matthieuvigne/eurobot_beacon/Documentation/Figures/IC_Documentation_Receiver.pdf

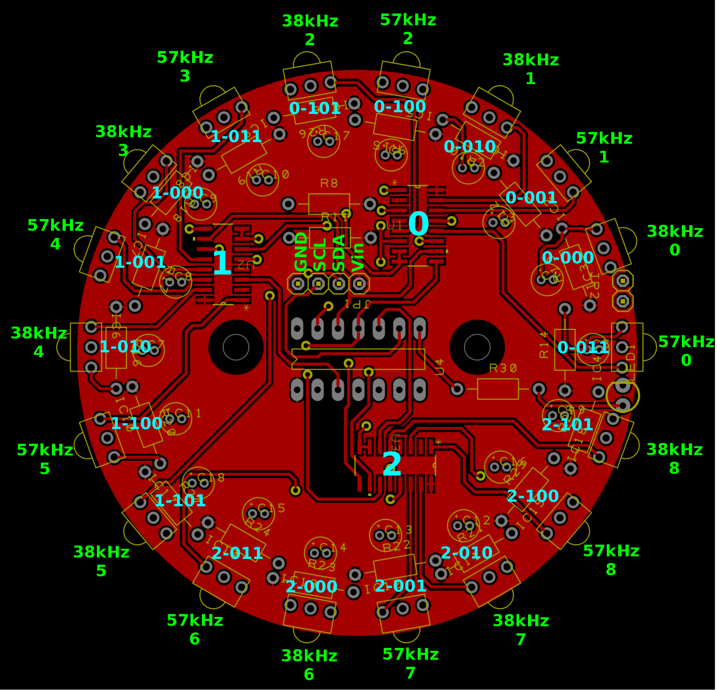
[picture p8: page 1]

0
1

2

0-011

1-011

2-011

0-000

0-001

0-010

0-101 0-100

2-101

1-101 | 2-100

1-100

2-010

1-010

2-001

1-001

1-000

2-000
