matthieuvigne/eurobot_beacon/PCBs/ATTinyProgrammerBoard-Schematic.pdf

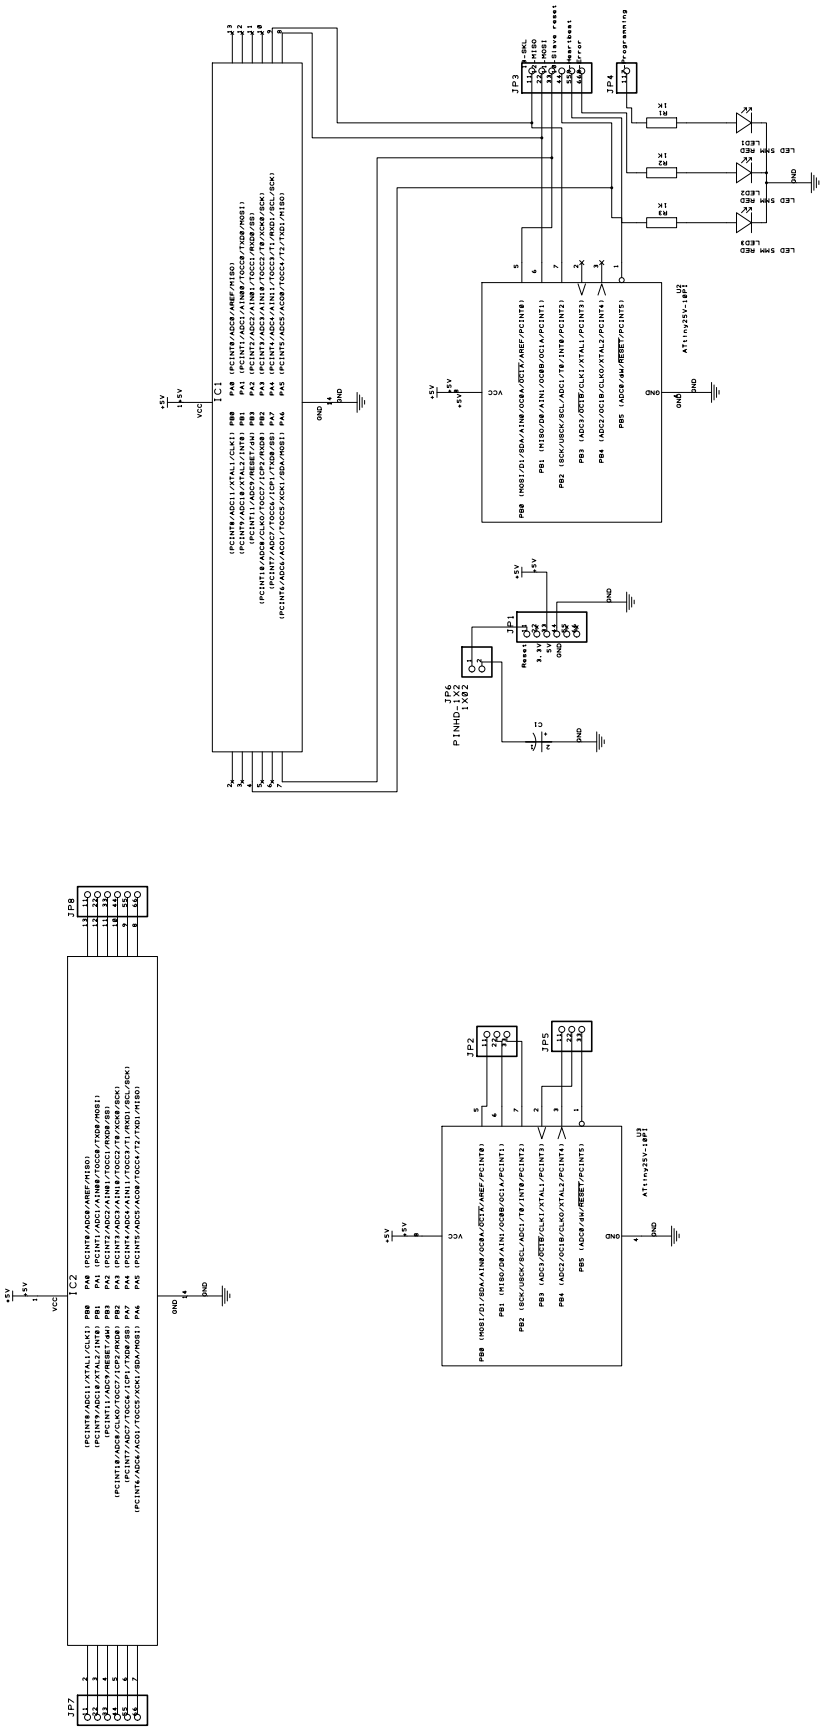
[picture p9: page 1]
