matthieuvigne/eurobot_beacon/PCBs/Emitter-Schematic.pdf

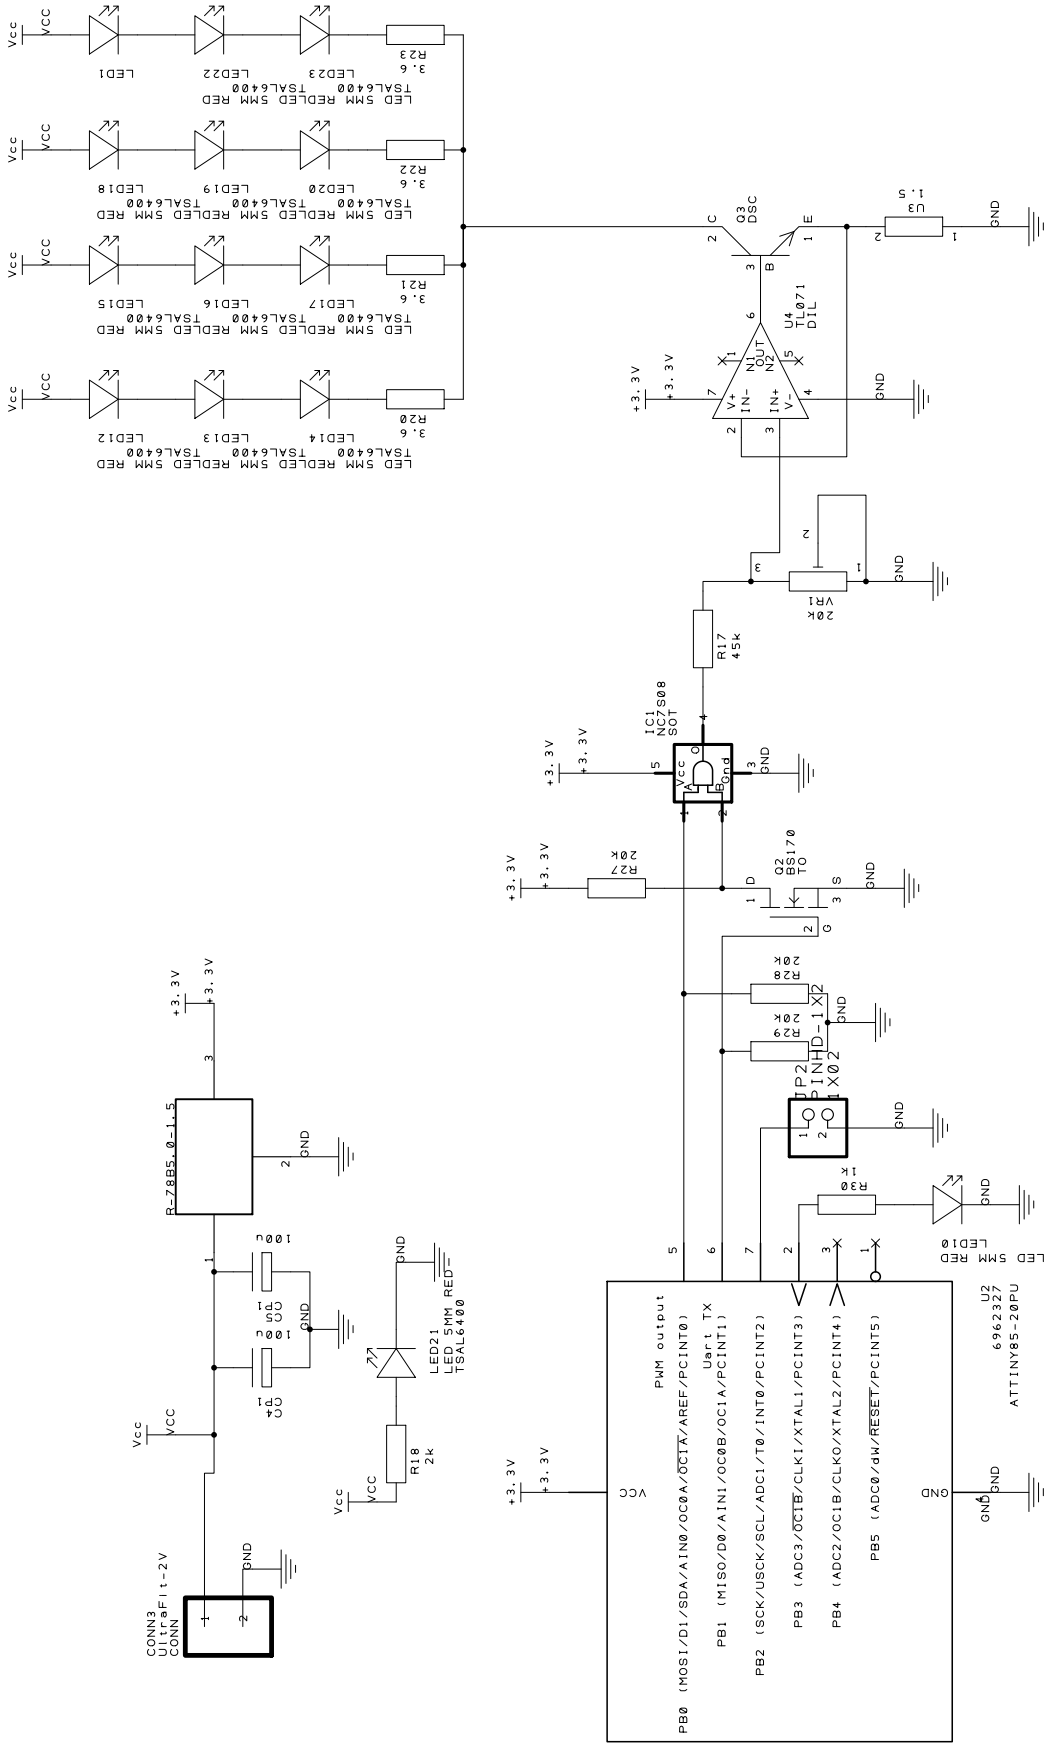
[picture p10: page 1]
