matthieuvigne/eurobot_beacon/PCBs/Reciever-Schematic.pdf

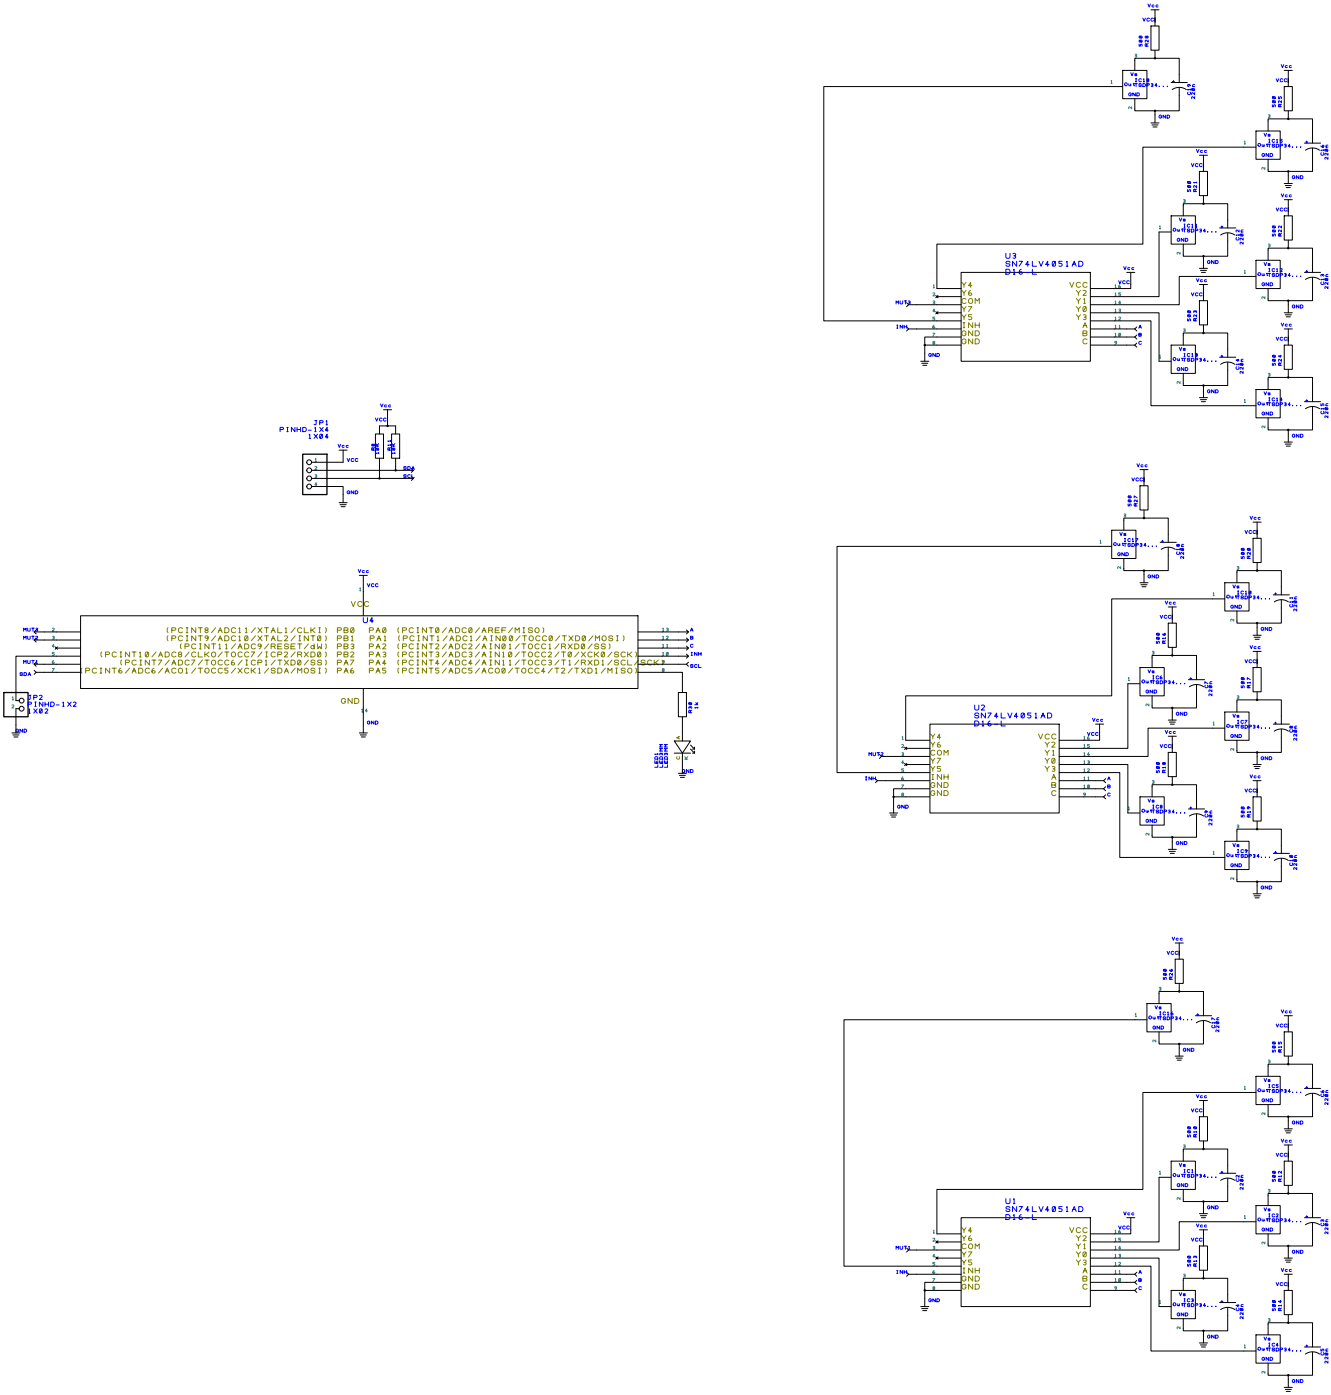
[picture p11: page 1]
