matthieuvigne/eurobot_beacon/PCBs/ATTinyProgrammerBoard-PCB.pdf

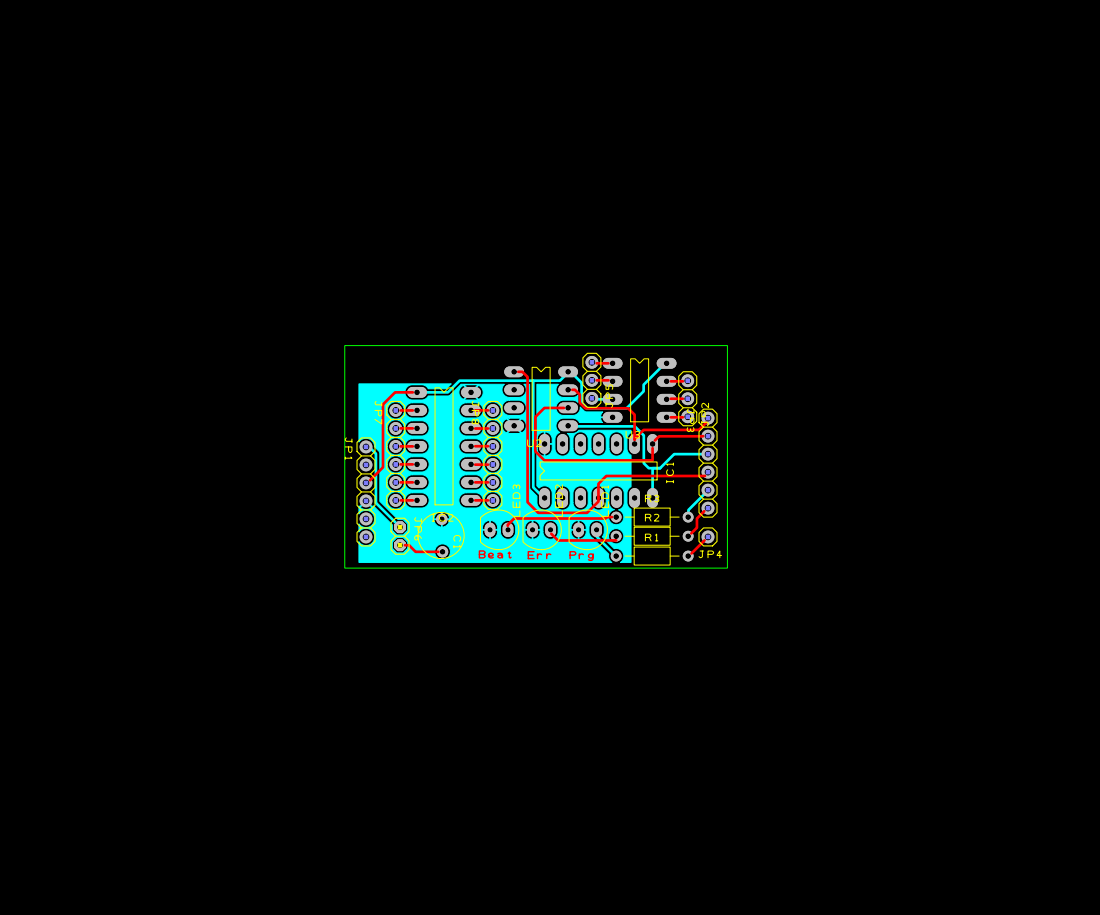
[picture p12: page 1]
