matthieuvigne/eurobot_beacon/PCBs/Emitter-PCB.pdf

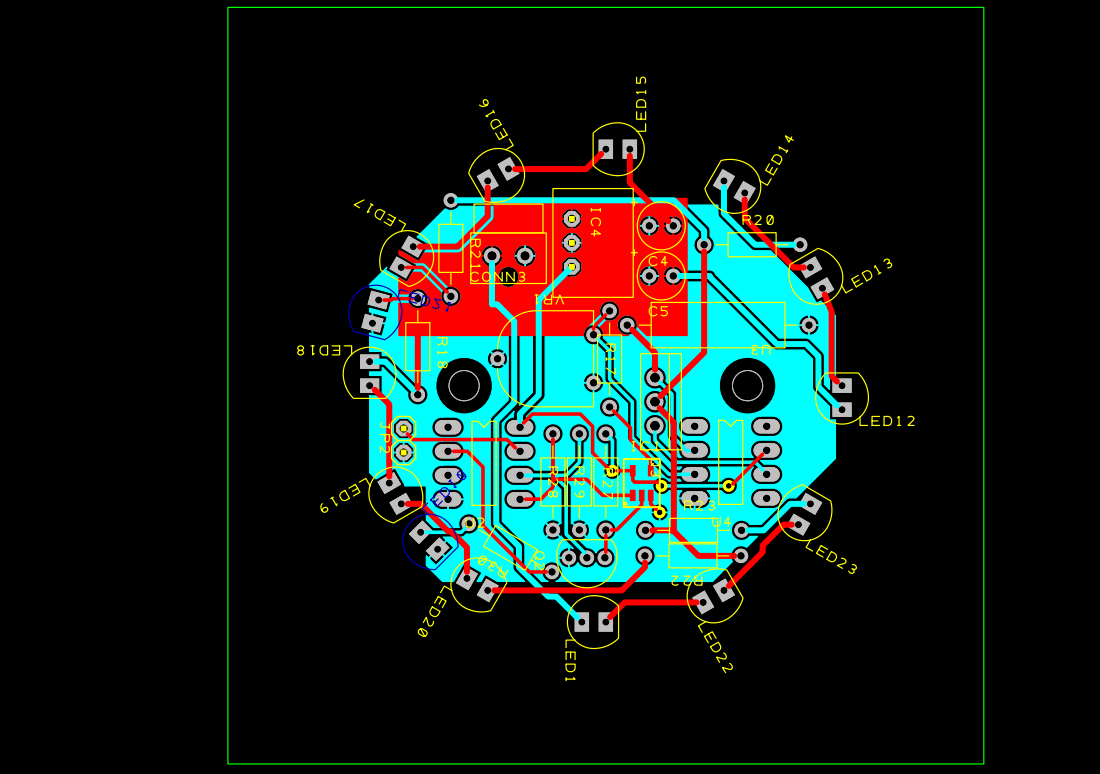
[picture p13: page 1]
