matthieuvigne/eurobot_beacon/PCBs/Reciever-PCB.pdf

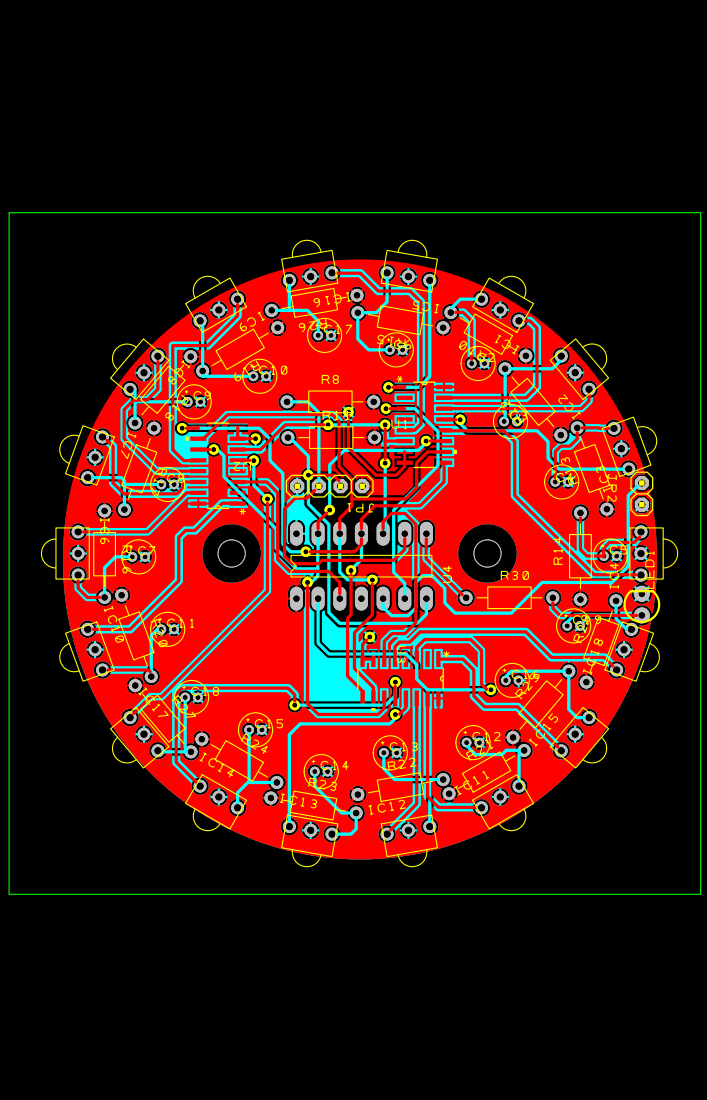
[picture p14: page 1]
