matthieuvigne/eurobot_beacon/(list of files, drawings)

Other design files:
PCBs/ATTinyProgrammerBoard.pcb
PCBs/Emitter.pcb
PCBs/Reciever.pcb
