matthieuvigne/eurobot_beacon/(commit log)

2018-06-03 Create eurobot_beacon project, with 2018 beacon design.
    This repo contains all the elements required to understand and build these beacons:
    - sensor documentation and design information.
    - hardware (PCB) files.
    - microcontroller code.
    - example code.
    [ATTinyProgrammerBoard.pcb, ATTinyProgrammerBoard.sch, Emitter.pcb, Emitter.sch, Reciever.pcb, Reciever.sch]
2018-06-03 Update README ; add schematic PDF files.
2018-06-17 Add DesignUpdate with info concerning V2 design. Typo fixup and README update.
    [Receiver.ino]
2018-06-27 [PCBs] Add pdf of PCB files.
